xlazam01/CEM60_USB_CommBoard/Photos/IMG_2137.jpg

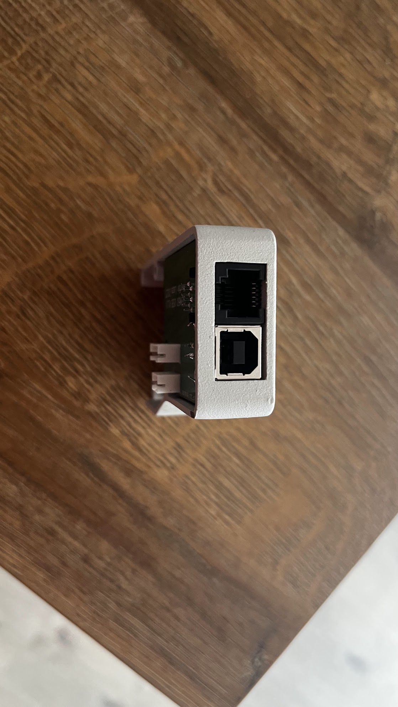
Photos/IMG_2137.jpg
