xlazam01/CEM60_USB_CommBoard/readme.md

# iOptron CEM60 USB Communication

This is a small project which enabled CEM60 mount to communicate directly over USB instead of RS232.

# Files

Schematic and PCB files in repository

## Photos

See Photos folder for final result

# Instalation

1. Remove the cover with RS232 connector
2. Disconnect two cables
3. Remove old PCB
4. Install new USB enabled PCB
5. Plug cables back
6. Reinstall board and cover
7. Have fun!!
