xlazam01/CEM60_USB_CommBoard/CEM60_USB_CommBoard.kicad_pcb

## KiCad design CEM60_USB_CommBoard.kicad_pcb (2023-08-04)

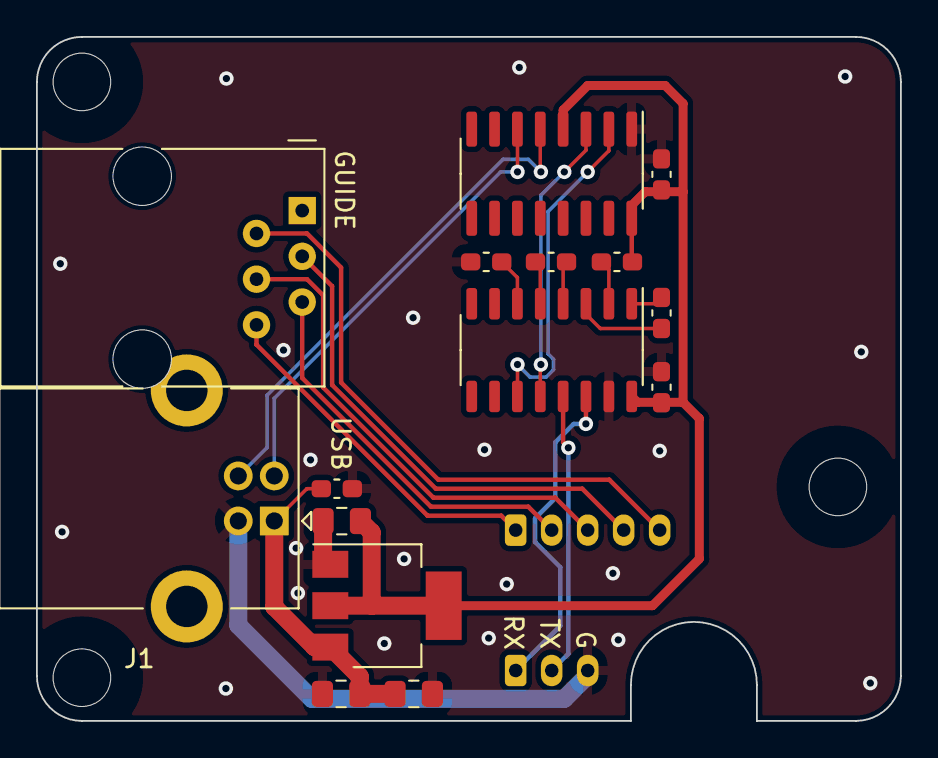
[picture p5: board CEM60_USB_CommBoard.kicad_pcb from above]

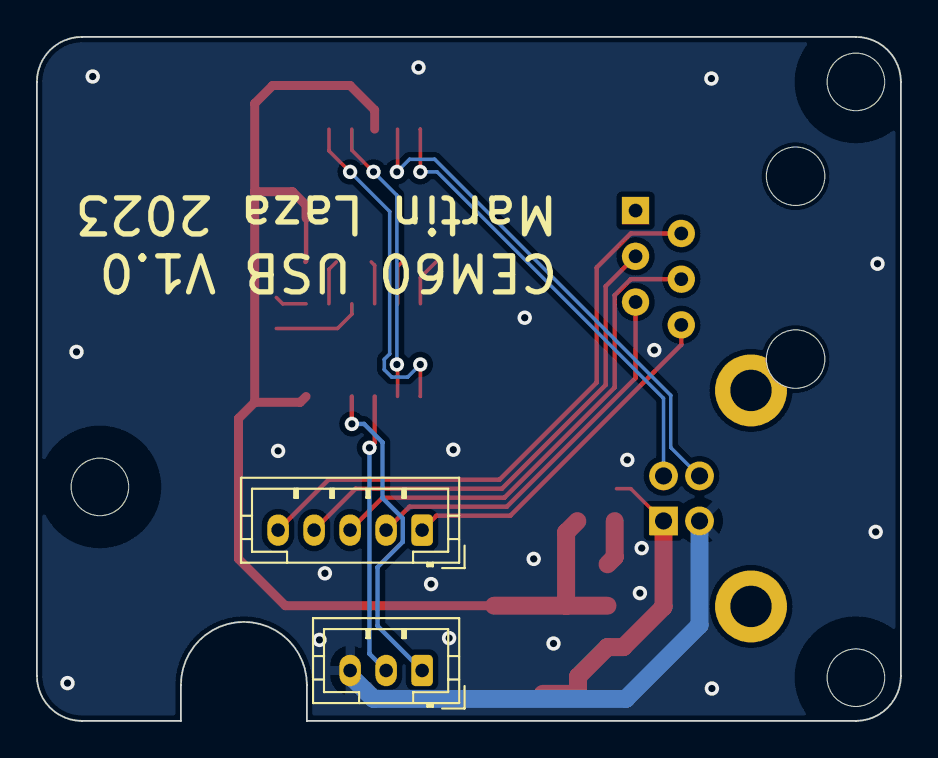
[picture p6: board CEM60_USB_CommBoard.kicad_pcb from below]

Board: 2 copper layers, 48.0 x 38.0 mm, 17 parts (2 on the bottom side), 20 nets.

Parts:
C1, C2, C4: 10u/25V/0805; C_0805_2012Metric_Pad1.18x1.45mm_HandSolder
C3, C5, C6, C7, C8, C9, C10: 100n/50V/0603; C_0603_1608Metric_Pad1.08x0.95mm_HandSolder
J1: USB_B; USB_B_Lumberg_2411_02_Horizontal
J2: 6P6C; RJ12_Amphenol_54601
J3: Conn_01x04; JST_PH_B3B-PH-K_1x03_P2.00mm_Vertical
J4: Conn_01x05; JST_PH_B5B-PH-K_1x05_P2.00mm_Vertical
U1: MAX3232; SO-16_3.9x9.9mm_P1.27mm
U2: CH340C; SOIC-16_3.9x9.9mm_P1.27mm
U3: AMS1117-3.3; SOT-223-3_TabPin2

Connections:
+3.3V: C4.1, C5.2, C6.2, C10.2, U1.16 (VCC), U2.4 (V3), U2.16 (VCC), U3.2 (VO)
/RX: J3.1, U1.14 (T1OUT)
/TX: J3.2, U1.13 (R1IN)
GND: C1.2, C2.2, C3.1, C4.2, C5.1, C7.2, C10.1, J1.4 (GND), J3.3, U1.15 (GND), U2.1 (GND), U3.1 (GND)
unnamed: J1.3 (D+), U2.5 (UD+)
unnamed: J1.2 (D-), U2.6 (UD-)
unnamed: J2.6, J4.1
unnamed: J2.5, J4.2
unnamed: J2.4, J4.3
unnamed: J2.3, J4.4
unnamed: J2.2, J4.5
unnamed: C9.1, U1.1 (C1+)
unnamed: C9.2, U1.3 (C1-)
unnamed: C8.1, U1.4 (C2+)
unnamed: C8.2, U1.5 (C2-)
unnamed: U1.12 (R1OUT), U2.3 (RXD)
unnamed: U1.11 (T1IN), U2.2 (TXD)
unnamed: C6.1, U1.2 (VS+)
unnamed: C7.1, U1.6 (VS-)
VBUS: C1.1, C2.1, C3.2, J1.1 (VBUS), U3.3 (VI)
